noxrick91/caw-bms/PCB/Model/IND-SMD_L7.0-W6.6~IND-SMD_L7.0-W6.6-H3.0.step

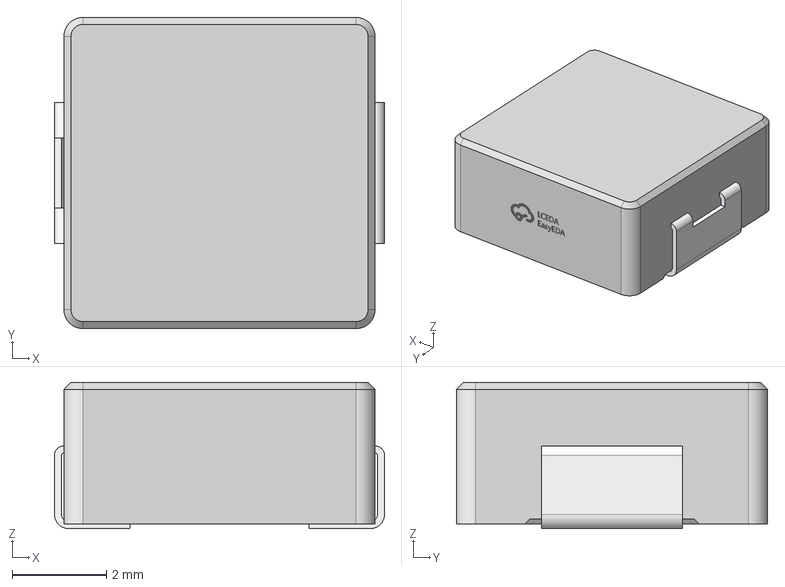
[picture p1: CAD file, 2026-03-03]
PCB/Model/IND-SMD_L7.0-W6.6~IND-SMD_L7.0-W6.6-H3.0.step
7.00 x 6.60 x 3.10 mm
