noxrick91/caw-bms/PCB/Model/VQFN-48_L7.0-W7.0-P0.50-BL-EP5.5~VQFN-48_L7.0-W7.0-P0.50-BL-EP5.5.step

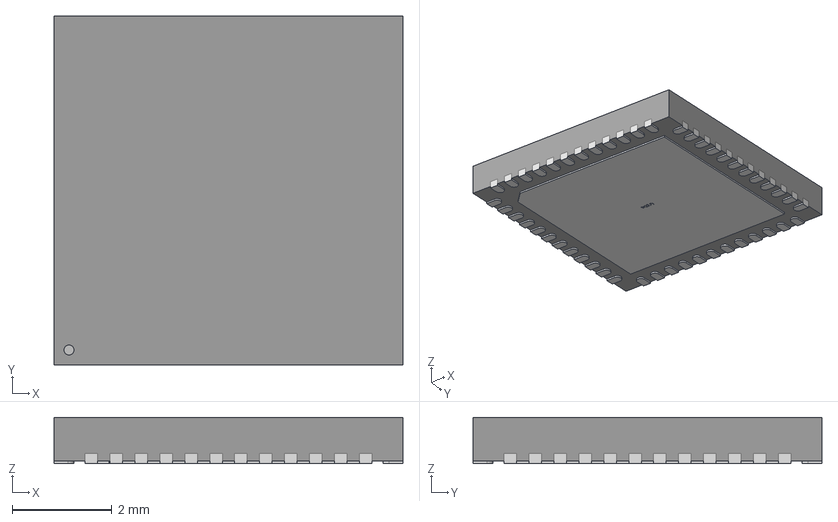
[picture p2: CAD file, 2026-03-03]
PCB/Model/VQFN-48_L7.0-W7.0-P0.50-BL-EP5.5~VQFN-48_L7.0-W7.0-P0.50-BL-EP5.5.step
7.00 x 7.00 x 0.93 mm
