noxrick91/caw-bms/caw-bms.ioc

Mcu.UserName=STM32L431CCUx
PA0.Signal=ADCx_IN5
PA1.Signal=ADCx_IN6
PA10.GPIO_Label=CAN_STB
PA10.Signal=GPIO_Output
PA11.Signal=CAN1_RX
PA12.Signal=CAN1_TX
PA3.Signal=ADCx_IN8
PA4.GPIO_Label=ALERT
PA4.Signal=GPXTI4
PA9.GPIO_Label=KEY_A
PA9.Signal=GPIO_Output
PB1.GPIO_Label=EN_PRE_CHARGE
PB1.Signal=GPIO_Output
PB10.Signal=I2C2_SCL
PB11.Signal=I2C2_SDA
PB12.GPIO_Label=EN_5V
PB12.Signal=GPIO_Output
PB5.Signal=SPI1_MOSI
PB6.Signal=USART1_TX
PB7.Signal=USART1_RX
