noxrick91/caw-bms/(commit log)

2026-03-03 feat(PCB): 新增预充功能; 支持2路电池温度采样; 支持低功耗模式; 更换主控芯片; 采用降压输出5V
    [BQ76920.kicad_sch, CawBMS.kicad_pcb, CawBMS.kicad_sch, IND-SMD_L7.0-W6.6~IND-SMD_L7.0-W6.6-H3.0.step, TPS5450DDAR.kicad_sch, VQFN-48_L7.0-W7.0-P0.50-BL-EP5.5~VQFN-48_L7.0-W7.0-P0.50-BL-EP5.5.step]
2026-03-15 fix(PCB): 调优放电/预充电阻功率与母线采样布局
    [BQ76920.kicad_sch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]
2026-03-15 refactor(PCB): 优化线宽
    [CawBMS.kicad_pcb]
